SameSameIndustry/STM32_UDP2CAN_controller/CAN_PROTOCOL_TTL-SERVO.md

# CAN 通信プロトコル仕様書

実装: [`Core/Inc/can_protocol.h`](Core/Inc/can_protocol.h) / [`Core/Src/can_protocol.c`](Core/Src/can_protocol.c)

## バス設定

| 項目 | 値 |
|---|----|
| ボーレート | 1 Mbps（クラシック CAN） |
| ID 形式 | 標準 11bit |
| ノード ID | `0x21`（`can_protocol.h` の `CAN_NODE_ID` で変更可能） |
| 通信方向 | 受信専用（この基板からは送信しない） |

## フレームフォーマット

`Data[0]` がコマンドバイト、`Data[1..]` がペイロード（リトルエンディアン）。

| コマンド | `Data[0]` | DLC | ペイロード |
|---|:---:|:---:|---|
| RESET | `0x00` | 1 | なし |
| SET_TARGET | `0x01` | 3 | `Data[1:2]` = **int16 LE（符号付き）**、絶対原点（180°固定、生カウント2048）からのオフセット（カウント単位、`角度[°] = カウント値 × 360 / 4096`、範囲 ±180°＝±2048） |

原点は180°（生カウント2048）に固定されており、原点自体を動かすコマンドはない。STS3215サーボの`Present_Position`/`Goal_Position`は0〜4095（0〜360°）レンジ。

## 挙動

| 送信データ | 挙動 |
|---|---|
| `ID=0x21 Data=00` | サーボの現在位置を読み取り、それを新しい目標値としてそのまま指令する（その場で停止） |
| `ID=0x21 Data=01 00 00`（オフセット0） | 目標角度を原点そのもの＝180°に更新 |
| `ID=0x21 Data=01 00 04`（オフセット +1024 = +90°） | 目標角度を180°+90°=270°（生カウント3072）に更新 |
| `ID=0x21 Data=01 00 FC`（オフセット -1024 = -90°） | 目標角度を180°-90°=90°（生カウント1024）に更新 |

目標値（180°±オフセット）は0〜4095にクランプされる（`wave_motor`用プロトコルと異なり、範囲外はラップせず両端で頭打ちになる）。

`CAN_NODE_ID` 以外宛のフレームとリモートフレームは無視される。

## LEDインジケータ（PA8、WS2812B互換 ×6、デイジーチェーン）

受信したコマンドに応じて、6灯すべてを同じ色に切り替える（[`Core/Src/ws2812.c`](STM_TTLSERVO/Core/Src/ws2812.c) 実装）。

| コマンド | LED色 |
|---|---|
| RESET | 白 |
| SET_TARGET | 青 |
