SameSameIndustry/STM32_UDP2CAN_controller/CAN_PROTOCOL_wave_motor.md

# CAN 通信プロトコル仕様書

実装: [`Core/Inc/can_protocol.h`](Core/Inc/can_protocol.h) / [`Core/Src/can_protocol.c`](Core/Src/can_protocol.c)

## バス設定

| 項目 | 値 |
|---|----|
| ボーレート | 1 Mbps（クラシック CAN） |
| ID 形式 | 標準 11bit |
| ノード ID | `0x11`（`can_protocol.h` の `CAN_NODE_ID` で変更可能） |
| 通信方向 | 受信専用（この基板からは送信しない） |

## フレームフォーマット

`Data[0]` がコマンドバイト、`Data[1..]` がペイロード（リトルエンディアン）。

| コマンド | `Data[0]` | DLC | ペイロード |
|---|:---:|:---:|---|
| RESET | `0x00` | 1 | なし |
| SET_TARGET | `0x01` | 3 | `Data[1:2]` = **int16 LE（符号付き）**、絶対原点（AS5600 生カウント 2048 = 180°固定）からのオフセット（カウント単位、`角度[°] = カウント値 × 360 / 4096`、±180° ≒ ±2048） |

原点は AS5600 の絶対値 180°（生カウント 2048）に固定されており、`SET_ORIGIN` のような動的な原点変更コマンドは無い。

## 挙動

| 送信データ | 挙動 |
|---|---|
| `ID=0x11 Data=00` | 現在位置を新しい目標値にする → 現在の速度からなめらかに減速してその場に停止する |
| `ID=0x11 Data=01 00 00`（オフセット 0） | 目標角度を絶対原点そのもの＝180°に更新 |
| `ID=0x11 Data=01 00 04`（オフセット +1024 = +90°） | 目標角度を 180°+90° = 270°（AS5600 生カウント 3072）に更新 |
| `ID=0x11 Data=01 00 FC`（オフセット -1024 = -90°） | 目標角度を 180°-90° = 90°（AS5600 生カウント 1024）に更新 |

範囲外の値（例: ±180° を超えるオフセット）を送っても拒否はされず、円周上をラップして解釈される。`CAN_NODE_ID` 以外宛のフレームとリモートフレームは無視される。
