SameSameIndustry/STM32_UDP2CAN_controller/UDP_w5500/jlcpcb/production_files/BOM-UDP_w5500.csv

Comment | Designator | Footprint | LCSC | Quantity
0R/1206 | R22 | R_1206_3216Metric | C22356801 | 1
100nF | C14,C2,C22,C26,C27,C30,C31,C32,C33,C5,C8 | C_0603_1608Metric_Pad1.08x0.95mm_HandSolder | C14663 | 11
10K | R23,R25 | R_0603_1608Metric_Pad0.98x0.95mm_HandSolder | C25804 | 2
10R | R21 | R_0603_1608Metric_Pad0.98x0.95mm_HandSolder | C22859 | 1
10nF | C15,C18,C29 | C_0603_1608Metric_Pad1.08x0.95mm_HandSolder | C57112 | 3
10uF | C13,C6 | C_0603_1608Metric_Pad1.08x0.95mm_HandSolder | C19702 | 2
12.4K | R19 | R_0603_1608Metric_Pad0.98x0.95mm_HandSolder | C22865 | 1
120R | R7,R8 | R_0603_1608Metric_Pad0.98x0.95mm_HandSolder | C22787 | 2
16Hz | Y2 | Crystal_SMD_3225-4Pin_3.2x2.5mm | C13738 | 1
18pF | C10,C9 | C_0603_1608Metric_Pad1.08x0.95mm_HandSolder | C1647 | 2
1uF | C25 | C_0603_1608Metric_Pad1.08x0.95mm_HandSolder | C15849 | 1
1uF/35V | C7 | C_0603_1608Metric_Pad1.08x0.95mm_HandSolder | C15849 | 1
2.2K | R27,R28 | R_0603_1608Metric_Pad0.98x0.95mm_HandSolder | C4190 | 2
22nF | C19 | C_0603_1608Metric_Pad1.08x0.95mm_HandSolder | C21122 | 1
22uF | C12,C16 | C_0603_1608Metric_Pad1.08x0.95mm_HandSolder | C59461 | 2
25MHz | Y1 | Crystal_SMD_3225-4Pin_3.2x2.5mm | C9006 | 1
3.3R | R10,R11,R12,R9 | R_0603_1608Metric_Pad0.98x0.95mm_HandSolder | C22979 | 4
330R | R13,R14 | R_0603_1608Metric_Pad0.98x0.95mm_HandSolder | C23138 | 2
4.7K | R2,R3,R5 | R_0603_1608Metric_Pad0.98x0.95mm_HandSolder | C23162 | 3
4.7uF | C17,C28 | C_0603_1608Metric_Pad1.08x0.95mm_HandSolder | C19666 | 2
470 | R17,R24 | R_0603_1608Metric_Pad0.98x0.95mm_HandSolder | C23179 | 2
470R | R26 | R_0603_1608Metric_Pad0.98x0.95mm_HandSolder | C23179 | 1
49.9R | R15,R16,R18,R20 | R_0603_1608Metric_Pad0.98x0.95mm_HandSolder | C23185 | 4
6.8nF | C20,C21 | C_0603_1608Metric_Pad1.08x0.95mm_HandSolder | C1631 | 2
6.8pF | C23,C24 | C_0603_1608Metric_Pad1.08x0.95mm_HandSolder | C1679 | 2
74AHCT1G125 | U7 | SOT-23-5_HandSoldering | C20617900 | 1
AMS1117-3.3 | U4 | SOT-223-3_TabPin2 | C6186 | 1
AR02016 | SW1,SW2 | SW-SMD_L3.9-W3.0-P4.45 | C720477 | 2
Blue | D2,D3 | LED_0603_1608Metric_Pad1.05x0.95mm_HandSolder | C7012319 | 2
CYA1040-68UH | L2 | IND-SMD_L11.6-W10.1 | C6364682 | 1
LCMGG160808T121RG | L1 | L_0603_1608Metric | C14709 | 1
MCP2562-E-SN | U5 | SOIC-8_3.9x4.9mm_P1.27mm | C53609 | 1
S4B-PH-SM4 | J10,J11,J12,J9 | JST_PH_S4B-PH-SM4-TB_1x04-1MP_P2.00mm_Horizontal | C265102 | 4
SS34 | D1 | D_SMA | C8678 | 1
STM32G431CBTx | U6 | LQFP-48_7x7mm_P0.5mm | C529355 | 1
W5500 | U3 | LQFP-48_7x7mm_P0.5mm | C32843 | 1
XL1509-5.0 | U1 | SOIC-8_3.9x4.9mm_P1.27mm | C2902368 | 1
XT30-2+2 | J3 | CONN-TH_4P-XT30PW-M |  | 1
XT60 | J1 | AMASS_XT60IPW-M_1x03_P7.20mm_Horizontal |  | 1
470uF/35V | C4 | CP_Radial_D10.0mm_P5.00mm |  | 1
XT60 | J2 | AMASS_XT60PW-F_1x02_P7.20mm_Horizontal |  | 1
XT30-2+2 | J4 | CONN-TH_4P-XT30PW-M |  | 1
XT30-2+2 | J5 | CONN-TH_4P-XT30PW-M |  | 1
~ | J7 | RJ45-TH_HR911105A |  | 1
XT30-2+2 | J6 | CONN-TH_4P-XT30PW-M |  | 1
WS2812B | D4 | LED_WS2812B_PLCC4_5.0x5.0mm_P3.2mm |  | 1
GND | TP2 | TestPoint_Pad_D3.0mm |  | 1
2.54-5 | J8 | PinHeader_1x05_P2.54mm_Vertical |  | 1
5V | TP1 | TestPoint_Pad_D3.0mm |  | 1
WS2812B | D5 | LED_WS2812B_PLCC4_5.0x5.0mm_P3.2mm |  | 1
220uF/35V | C11 | CP_Radial_D8.0mm_P3.50mm |  | 1
WS2812B | D8 | LED_WS2812B_PLCC4_5.0x5.0mm_P3.2mm |  | 1
WS2812B | D11 | LED_WS2812B_PLCC4_5.0x5.0mm_P3.2mm |  | 1
WS2812B | D6 | LED_WS2812B_PLCC4_5.0x5.0mm_P3.2mm |  | 1
WS2812B | D9 | LED_WS2812B_PLCC4_5.0x5.0mm_P3.2mm |  | 1
WS2812B | D10 | LED_WS2812B_PLCC4_5.0x5.0mm_P3.2mm |  | 1
WS2812B | D7 | LED_WS2812B_PLCC4_5.0x5.0mm_P3.2mm |  | 1
