SameSameIndustry/STM32_UDP2CAN_controller/UDP_w5500/3D/3D/UDP_w5500.step

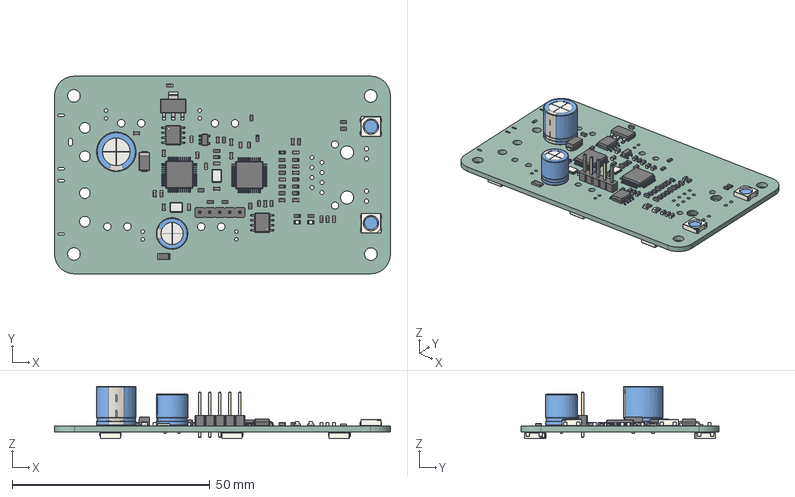
[picture p1: CAD file, 2026-08-07]
UDP_w5500/3D/3D/UDP_w5500.step
85.0 x 50.0 x 13.3 mm
C_0603_1608Metric x 29
R_0603_1608Metric x 24
CP_Radial_D10.0mm_P5.00mm
Crystal_SMD_3225-4Pin_3.2x2.5mm x 2
LED_0603_1608Metric x 2
L_0603_1608Metric
SOT-223
SOIC-8_3.9x4.9mm_P1.27mm x 2
LED_WS2812B_PLCC4_5.0x5.0mm_P3.2mm x 8
SOT-23-5
LQFP-48_7x7mm_P0.5mm x 2
PinHeader_1x05_P2.54mm_Vertical
CP_Radial_D8.0mm_P3.50mm
R_1206_3216Metric
D_SMA
UDP_w5500_PCB
