SameSameIndustry/STM32_UDP2CAN_controller/UDP_w5500/3D/3D_base_transperanet.stl

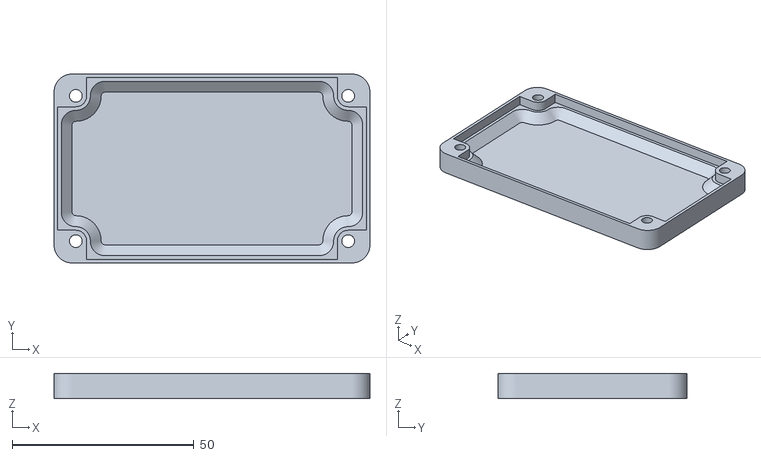
[picture p2: CAD file, 2026-10-04]
UDP_w5500/3D/3D_base_transperanet.stl
87.0 x 52.0 x 7.00
