SameSameIndustry/STM32_UDP2CAN_controller/UDP_w5500/3D/3D_base.stl

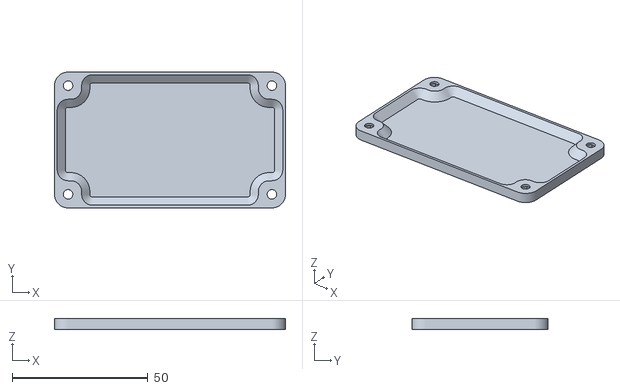
[picture p4: CAD file, 2026-08-07]
UDP_w5500/3D/3D_base.stl
85.0 x 50.0 x 4.00
