SameSameIndustry/STM32_UDP2CAN_controller/(list of files, cad)

Other CAD files:
UDP_w5500/3D/3D/UDP_w5500/UDP_w5500/CP_Radial_D10.0mm_P5.00mm.ipt
UDP_w5500/3D/3D/UDP_w5500/UDP_w5500/CP_Radial_D8.0mm_P3.50mm.ipt
UDP_w5500/3D/3D/UDP_w5500/UDP_w5500/C_0603_1608Metric.ipt
UDP_w5500/3D/3D/UDP_w5500/UDP_w5500/Crystal_SMD_3225-4Pin_3.2x2.5mm.ipt
UDP_w5500/3D/3D/UDP_w5500/UDP_w5500/D_SMA.ipt
UDP_w5500/3D/3D/UDP_w5500/UDP_w5500/LED_0603_1608Metric.ipt
UDP_w5500/3D/3D/UDP_w5500/UDP_w5500/LED_WS2812B_PLCC4_5.0x5.0mm_P3.2mm.ipt
UDP_w5500/3D/3D/UDP_w5500/UDP_w5500/LQFP-48_7x7mm_P0.5mm.ipt
UDP_w5500/3D/3D/UDP_w5500/UDP_w5500/L_0603_1608Metric.ipt
UDP_w5500/3D/3D/UDP_w5500/UDP_w5500/PinHeader_1x05_P2.54mm_Vertical.ipt
UDP_w5500/3D/3D/UDP_w5500/UDP_w5500/R_0603_1608Metric.ipt
UDP_w5500/3D/3D/UDP_w5500/UDP_w5500/R_1206_3216Metric.ipt
UDP_w5500/3D/3D/UDP_w5500/UDP_w5500/SOIC-8_3.9x4.9mm_P1.27mm.ipt
UDP_w5500/3D/3D/UDP_w5500/UDP_w5500/SOT-223.ipt
UDP_w5500/3D/3D/UDP_w5500/UDP_w5500/SOT-23-5.ipt
UDP_w5500/3D/3D/UDP_w5500/UDP_w5500/UDP_w5500.iam
UDP_w5500/3D/3D/UDP_w5500/UDP_w5500/UDP_w5500_PCB.ipt
UDP_w5500/3D/3D_base.ipt
UDP_w5500/3D/3D_base_transperanet.ipt
UDP_w5500/3D/3D_clear.ipt
UDP_w5500/3D/OldVersions/3D_base.0003.ipt
UDP_w5500/3D/OldVersions/3D_base_transperanet.0004.ipt
UDP_w5500/3D/OldVersions/3D_clear.0003.ipt
UDP_w5500/3D/UDP_w5500.step
UDP_w5500/3D/UDP_w5500/UDP_w5500/CP_Radial_D10.0mm_P5.00mm.ipt
UDP_w5500/3D/UDP_w5500/UDP_w5500/CP_Radial_D8.0mm_P3.50mm.ipt
UDP_w5500/3D/UDP_w5500/UDP_w5500/C_0603_1608Metric.ipt
UDP_w5500/3D/UDP_w5500/UDP_w5500/Crystal_SMD_3225-4Pin_3.2x2.5mm.ipt
UDP_w5500/3D/UDP_w5500/UDP_w5500/D_SMA.ipt
UDP_w5500/3D/UDP_w5500/UDP_w5500/LED_0603_1608Metric.ipt
UDP_w5500/3D/UDP_w5500/UDP_w5500/LED_WS2812B_PLCC4_5.0x5.0mm_P3.2mm.ipt
UDP_w5500/3D/UDP_w5500/UDP_w5500/LQFP-48_7x7mm_P0.5mm.ipt
UDP_w5500/3D/UDP_w5500/UDP_w5500/L_0603_1608Metric.ipt
UDP_w5500/3D/UDP_w5500/UDP_w5500/PinHeader_1x05_P2.54mm_Vertical.ipt
UDP_w5500/3D/UDP_w5500/UDP_w5500/R_0603_1608Metric.ipt
UDP_w5500/3D/UDP_w5500/UDP_w5500/R_1206_3216Metric.ipt
UDP_w5500/3D/UDP_w5500/UDP_w5500/SOIC-8_3.9x4.9mm_P1.27mm.ipt
UDP_w5500/3D/UDP_w5500/UDP_w5500/SOT-223.ipt
UDP_w5500/3D/UDP_w5500/UDP_w5500/SOT-23-5.ipt
UDP_w5500/3D/UDP_w5500/UDP_w5500/UDP_w5500.iam
UDP_w5500/3D/UDP_w5500/UDP_w5500/UDP_w5500_PCB.ipt
