SameSameIndustry/STM32_UDP2CAN_controller/UDP_w5500/schematics_w5500.pdf

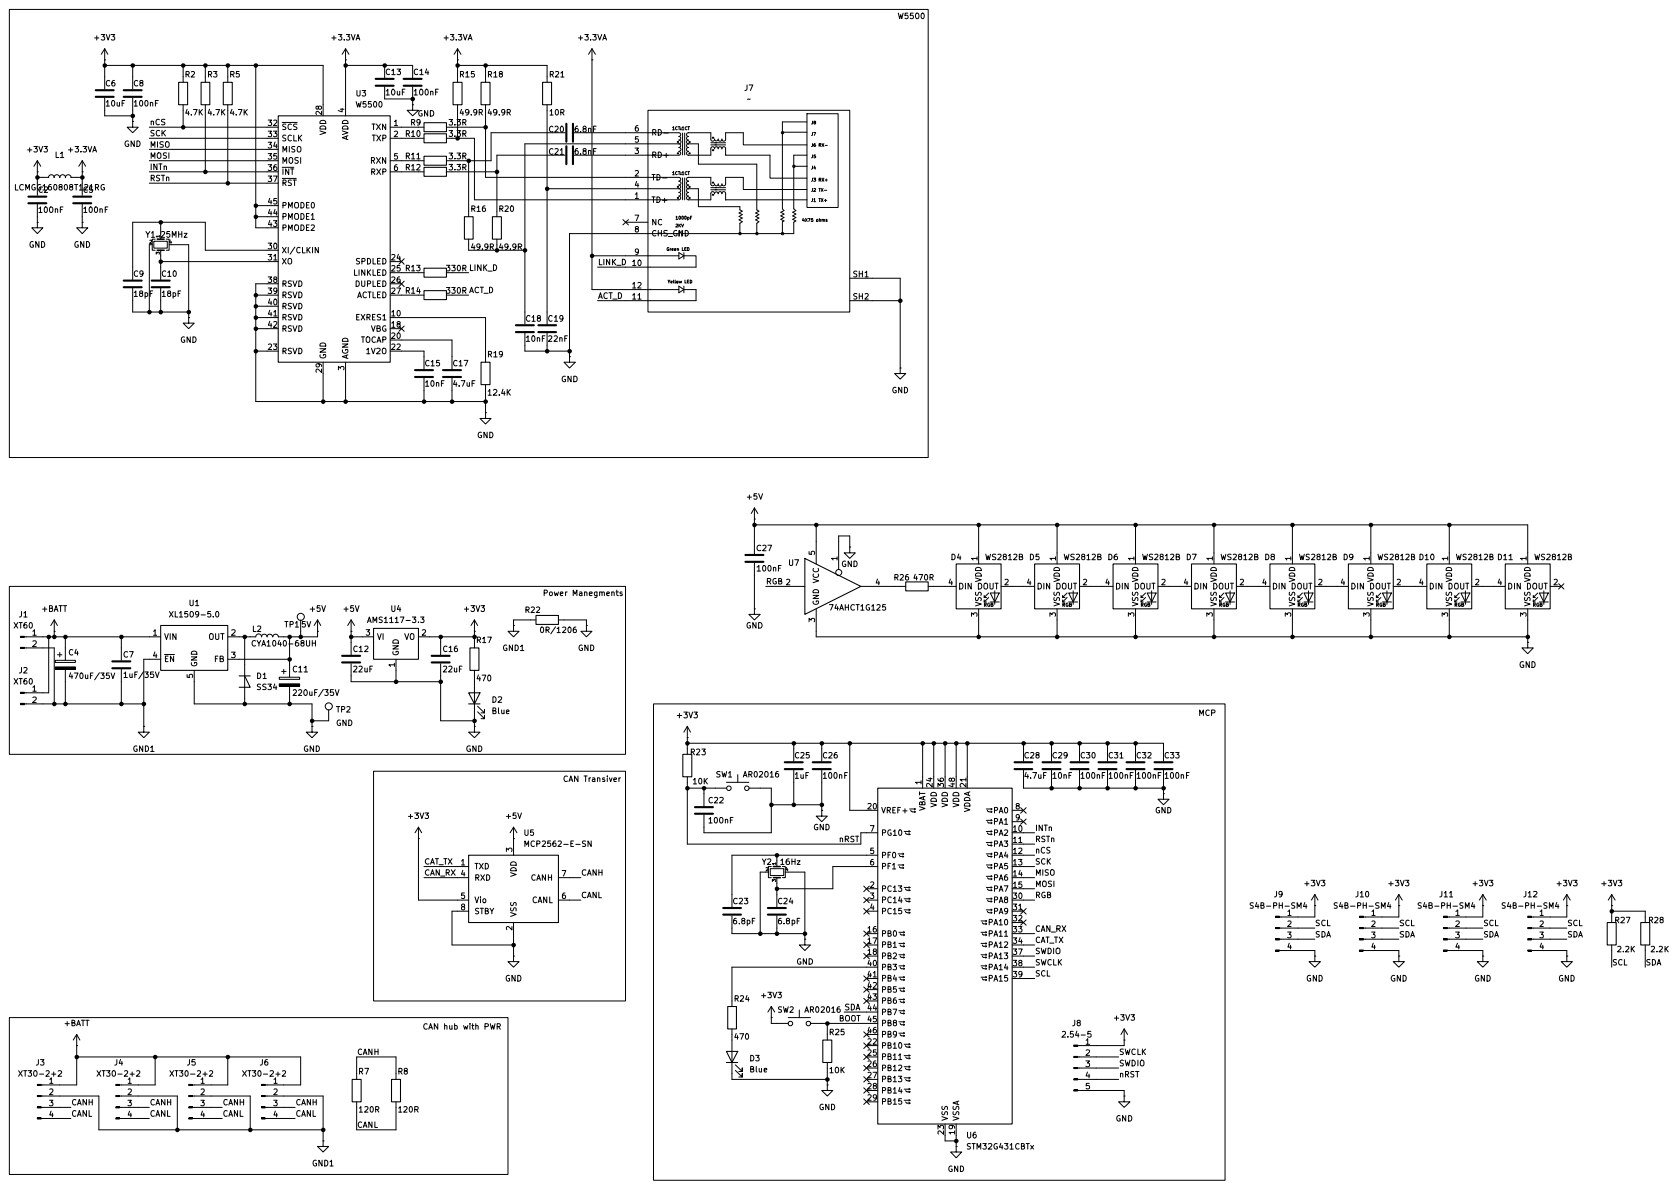
[picture p5: page 1]
