SameSameIndustry/STM32_UDP2CAN_controller/UDP_w5500/UDP_w5500.kicad_pcb

## KiCad design UDP_w5500/UDP_w5500.kicad_pcb (2026-08-07)

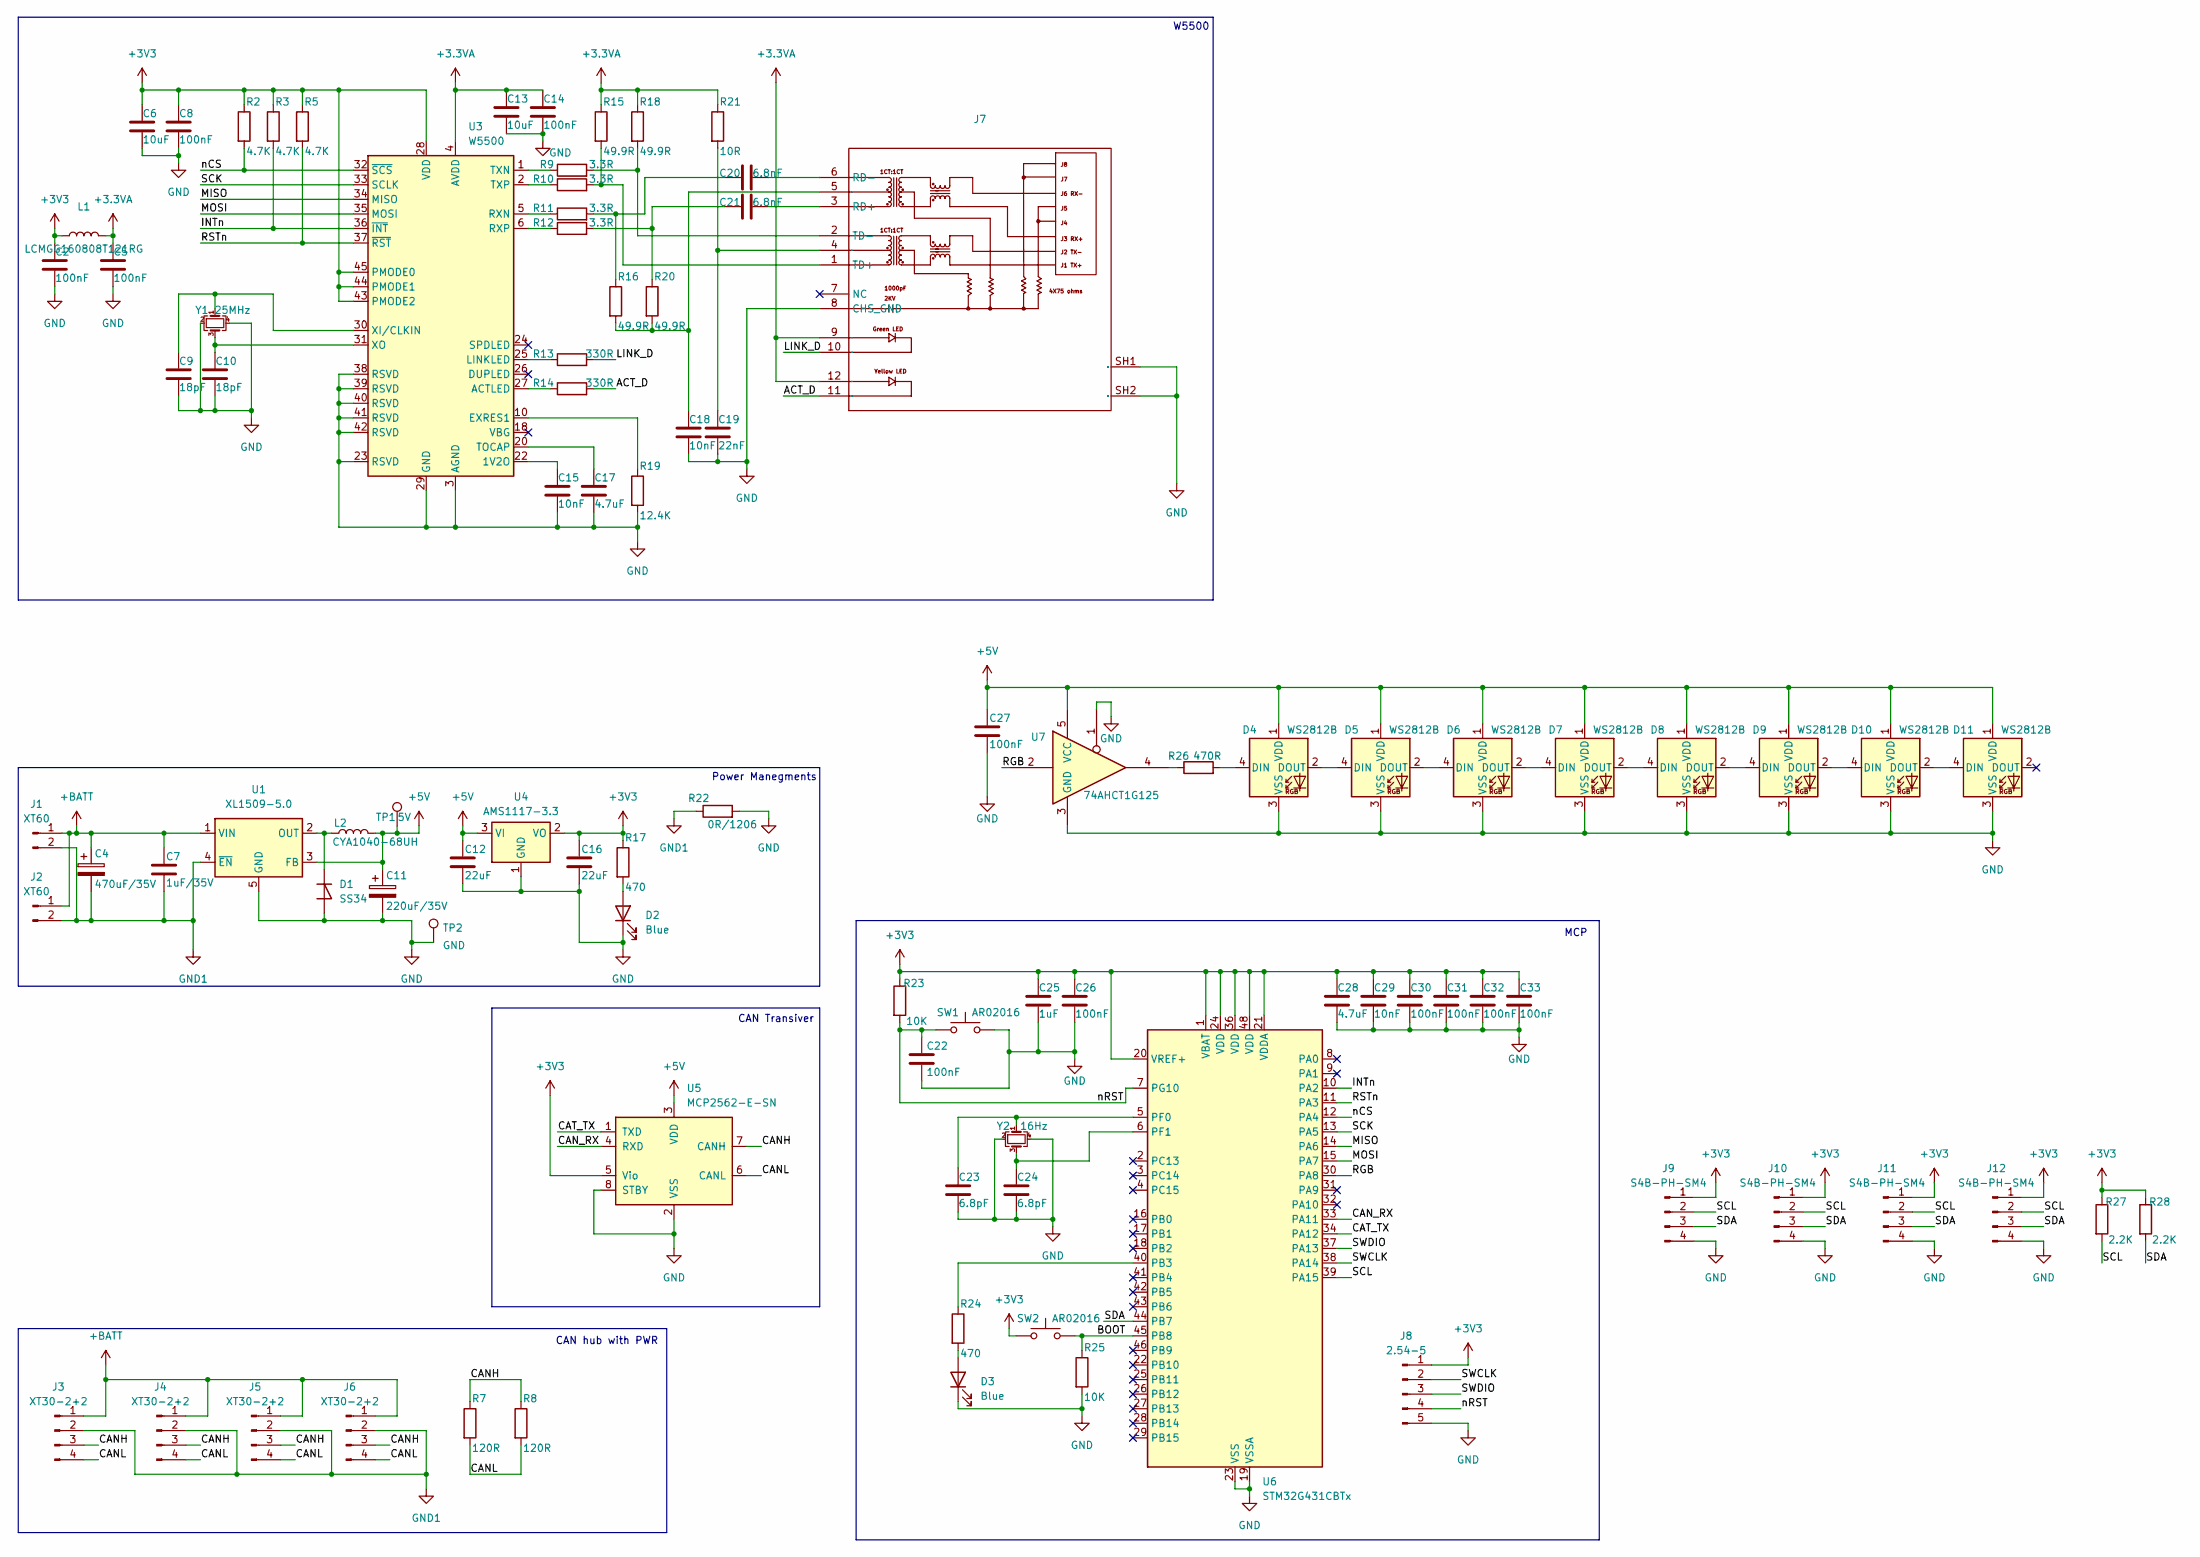
[picture p6: schematic UDP_w5500.kicad_sch]

Parts:
C2, C5, C8, C14, C22, C26, C27, C30, C31, C32, C33: 100nF; C_0603_1608Metric_Pad1.08x0.95mm_HandSolder; LCSC C14663
C4: 470uF/35V; CP_Radial_D10.0mm_P5.00mm
C6, C13: 10uF; C_0603_1608Metric_Pad1.08x0.95mm_HandSolder; LCSC C19702
C7: 1uF/35V; C_0603_1608Metric_Pad1.08x0.95mm_HandSolder; LCSC C15849
C9, C10: 18pF; C_0603_1608Metric_Pad1.08x0.95mm_HandSolder; LCSC C1647
C11: 220uF/35V; CP_Radial_D8.0mm_P3.50mm
C12, C16: 22uF; C_0603_1608Metric_Pad1.08x0.95mm_HandSolder; LCSC C59461
C15, C18, C29: 10nF; C_0603_1608Metric_Pad1.08x0.95mm_HandSolder; LCSC C57112
C17, C28: 4.7uF; C_0603_1608Metric_Pad1.08x0.95mm_HandSolder; LCSC C19666
C19: 22nF; C_0603_1608Metric_Pad1.08x0.95mm_HandSolder; LCSC C21122
C20, C21: 6.8nF; C_0603_1608Metric_Pad1.08x0.95mm_HandSolder; LCSC C1631
C23, C24: 6.8pF; C_0603_1608Metric_Pad1.08x0.95mm_HandSolder; LCSC C1679
C25: 1uF; C_0603_1608Metric_Pad1.08x0.95mm_HandSolder; LCSC C15849
D1: SS34; D_SMA; LCSC C8678
D2, D3: Blue; LED_0603_1608Metric_Pad1.05x0.95mm_HandSolder; LCSC C7012319
D4, D5, D6, D7, D8, D9, D10, D11: WS2812B; LED_WS2812B_PLCC4_5.0x5.0mm_P3.2mm
J1: XT60; AMASS_XT60IPW-M_1x03_P7.20mm_Horizontal
J2: XT60; AMASS_XT60PW-F_1x02_P7.20mm_Horizontal
J3, J4, J5, J6: XT30-2+2; CONN-TH_4P-XT30PW-M
J7: RJ45-TH_HR911105A; Manufacturer Part HR911105A; LCSC Part Name 弯插 带LED
J8: 2.54-5; PinHeader_1x05_P2.54mm_Vertical
J9, J10, J11, J12: S4B-PH-SM4; JST_PH_S4B-PH-SM4-TB_1x04-1MP_P2.00mm_Horizontal; LCSC C265102
L1: LCMGG160808T121RG; L_0603_1608Metric; LCSC C14709
L2: CYA1040-68UH; IND-SMD_L11.6-W10.1; LCSC C6364682
R2, R3, R5: 4.7K; R_0603_1608Metric_Pad0.98x0.95mm_HandSolder; LCSC C23162
R7, R8: 120R; R_0603_1608Metric_Pad0.98x0.95mm_HandSolder; LCSC C22787
R9, R10, R11, R12: 3.3R; R_0603_1608Metric_Pad0.98x0.95mm_HandSolder; LCSC C22979
R13, R14: 330R; R_0603_1608Metric_Pad0.98x0.95mm_HandSolder; LCSC C23138
R15, R16, R18, R20: 49.9R; R_0603_1608Metric_Pad0.98x0.95mm_HandSolder; LCSC C23185
R17, R24: 470; R_0603_1608Metric_Pad0.98x0.95mm_HandSolder; LCSC C23179
R19: 12.4K; R_0603_1608Metric_Pad0.98x0.95mm_HandSolder; LCSC C22865
R21: 10R; R_0603_1608Metric_Pad0.98x0.95mm_HandSolder; LCSC C22859
R22: 0R/1206; R_1206_3216Metric; LCSC C22356801
R23, R25: 10K; R_0603_1608Metric_Pad0.98x0.95mm_HandSolder; LCSC C25804
R26: 470R; R_0603_1608Metric_Pad0.98x0.95mm_HandSolder; LCSC C23179
R27, R28: 2.2K; R_0603_1608Metric_Pad0.98x0.95mm_HandSolder; LCSC C4190
SW1, SW2: AR02016; SW-SMD_L3.9-W3.0-P4.45; LCSC C720477
TP1: 5V; TestPoint_Pad_D3.0mm
TP2: GND; TestPoint_Pad_D3.0mm
U1: XL1509-5.0; SOIC-8_3.9x4.9mm_P1.27mm; LCSC C2902368
U3: W5500; LQFP-48_7x7mm_P0.5mm; LCSC C32843
U4: AMS1117-3.3; SOT-223-3_TabPin2; LCSC C6186
U5: MCP2562-E-SN; SOIC-8_3.9x4.9mm_P1.27mm; LCSC C53609
U6: STM32G431CBTx; LQFP-48_7x7mm_P0.5mm; LCSC C529355
U7: 74AHCT1G125; SOT-23-5_HandSoldering; LCSC C20617900
Y1: 25MHz; Crystal_SMD_3225-4Pin_3.2x2.5mm; LCSC C9006
Y2: 16Hz; Crystal_SMD_3225-4Pin_3.2x2.5mm; LCSC C13738

Connections:
+3.3VA: C5.1, C13.1, C14.1, J7.9, J7.12, L1.2, R15.1, R18.1, R21.1, U3.4 (AVDD), U3.8 (AVDD), U3.11 (AVDD), U3.15 (AVDD), U3.17 (AVDD), U3.21 (AVDD)
+3V3: C2.1, C6.1, C8.1, C16.1, C25.1, C26.1, C28.1, C29.1, C30.1, C31.1, C32.1, C33.1, J8.1, J9.1, J10.1, J11.1, J12.1, L1.1, R2.1, R3.1, R5.1, R17.1, R23.1, R27.1, R28.1, SW2.1, U3.28 (VDD), U3.43 (PMODE2), U3.44 (PMODE1), U3.45 (PMODE0), U4.2 (VO), U5.5 (Vio), U6.1 (VBAT), U6.20 (VREF+), U6.21 (VDDA), U6.24 (VDD), U6.36 (VDD), U6.48 (VDD)
+5V: C11.1, C12.1, C27.1, D4.1 (VDD), D5.1 (VDD), D6.1 (VDD), D7.1 (VDD), D8.1 (VDD), D9.1 (VDD), D10.1 (VDD), D11.1 (VDD), L2.2, TP1.1, U1.3 (FB), U4.3 (VI), U5.3 (VDD), U7.5 (VCC)
+BATT: C4.1, C7.1, J1.1, J2.1, J3.1, J4.1, J5.1, J6.1, U1.1 (VIN)
/ACT_D: J7.11, R14.2
/BOOT: R25.1, SW2.2, U6.45 (PB8)
/CANH: J3.3, J4.3, J5.3, J6.3, R7.1, R8.1, U5.7 (CANH)
/CANL: J3.4, J4.4, J5.4, J6.4, R7.2, R8.2, U5.6 (CANL)
/CAN_RX: U5.4 (RXD), U6.33 (PA11)
/CAT_TX: U5.1 (TXD), U6.34 (PA12)
/INTn: R3.2, U3.36 (~INT), U6.10 (PA2)
/LINK_D: J7.10, R13.2
/MISO: U3.34 (MISO), U6.14 (PA6)
/MOSI: U3.35 (MOSI), U6.15 (PA7)
/RGB: U6.30 (PA8), U7.2
/RSTn: R5.2, U3.37 (~RST), U6.11 (PA3)
/SCK: U3.33 (SCLK), U6.13 (PA5)
/SCL: J9.2, J10.2, J11.2, J12.2, R27.2, U6.39 (PA15)
/SDA: J9.3, J10.3, J11.3, J12.3, R28.2, U6.44 (PB7)
/SWCLK: J8.2, U6.38 (PA14)
/SWDIO: J8.3, U6.37 (PA13)
/nCS: R2.2, U3.32 (~SCS), U6.12 (PA4)
/nRST: C22.1, J8.4, R23.2, SW1.1, U6.7 (PG10)
GND: C2.2, C5.2, C6.2, C8.2, C9.2, C10.2, C11.2, C12.2, C13.2, C14.2, C15.2, C16.2, C17.2, C18.2, C19.2, C22.2, C23.2, C24.2, C25.2, C26.2, C27.2, C28.2, C29.2, C30.2, C31.2, C32.2, C33.2, D1.2 (A), D2.1 (K), D3.1 (K), D4.3 (VSS), D5.3 (VSS), D6.3 (VSS), D7.3 (VSS), D8.3 (VSS), D9.3 (VSS), D10.3 (VSS), D11.3 (VSS), J7.8 (CHS_GND), J7.SH1, J7.SH2, J8.5, J9.4, J10.4, J11.4, J12.4, R19.2, R22.2, R25.2, SW1.2, TP2.1, U1.5 (GND), U1.6 (GND), U1.7 (GND), U1.8 (GND), U3.3 (AGND), U3.9 (AGND), U3.14 (AGND), U3.16 (AGND), U3.19 (AGND), U3.23 (RSVD), U3.29 (GND), U3.38 (RSVD), U3.39 (RSVD), U3.40 (RSVD), U3.41 (RSVD), U3.42 (RSVD), U3.48 (AGND), U4.1 (GND), U5.2 (VSS), U5.8 (STBY), U6.19 (VSSA), U6.23 (VSS), U6.35 (VSS), U6.47 (VSS), U7.1, U7.3 (GND), Y1.2, Y1.4, Y2.2, Y2.4
GND1: C4.2, C7.2, J1.2, J2.2, J3.2, J4.2, J5.2, J6.2, R22.1, U1.4 (~EN)
unnamed: C18.1, J7.5, R16.2, R20.2
unnamed: C19.1, J7.4, R21.2
unnamed: C20.1, R11.2, R16.1
unnamed: C21.1, R12.2, R20.1
unnamed: D1.1 (K), L2.1, U1.2 (OUT)
unnamed: D2.2 (A), R17.2
unnamed: D3.2 (A), R24.2
unnamed: D4.4 (DIN), R26.2
unnamed: D4.2 (DOUT), D5.4 (DIN)
unnamed: D5.2 (DOUT), D6.4 (DIN)
unnamed: D6.2 (DOUT), D7.4 (DIN)
unnamed: D7.2 (DOUT), D8.4 (DIN)
unnamed: D8.2 (DOUT), D9.4 (DIN)
unnamed: D9.2 (DOUT), D10.4 (DIN)
unnamed: D10.2 (DOUT), D11.4 (DIN)
unnamed: C21.2, J7.3 (RD+)
unnamed: C20.2, J7.6 (RD-)
unnamed: J7.1 (TD+), R10.2, R15.2
unnamed: J7.2 (TD-), R9.2, R18.2
unnamed: R26.1, U7.4
unnamed: C15.1, U3.22 (1V2O)
unnamed: R14.1, U3.27 (ACTLED)
unnamed: R19.1, U3.10 (EXRES1)
unnamed: R13.1, U3.25 (LINKLED)
unnamed: R11.1, U3.5 (RXN)
unnamed: R12.1, U3.6 (RXP)
unnamed: C17.1, U3.20 (TOCAP)
unnamed: R9.1, U3.1 (TXN)
unnamed: R10.1, U3.2 (TXP)
unnamed: C9.1, U3.30 (XI/CLKIN), Y1.1
unnamed: C10.1, U3.31 (XO), Y1.3
unnamed: R24.1, U6.40 (PB3)
unnamed: C23.1, U6.5 (PF0), Y2.1
unnamed: C24.1, U6.6 (PF1), Y2.3

Notes on the sheet:
CAN hub with PWR
MCP
W5500
Power Manegments
CAN Transiver

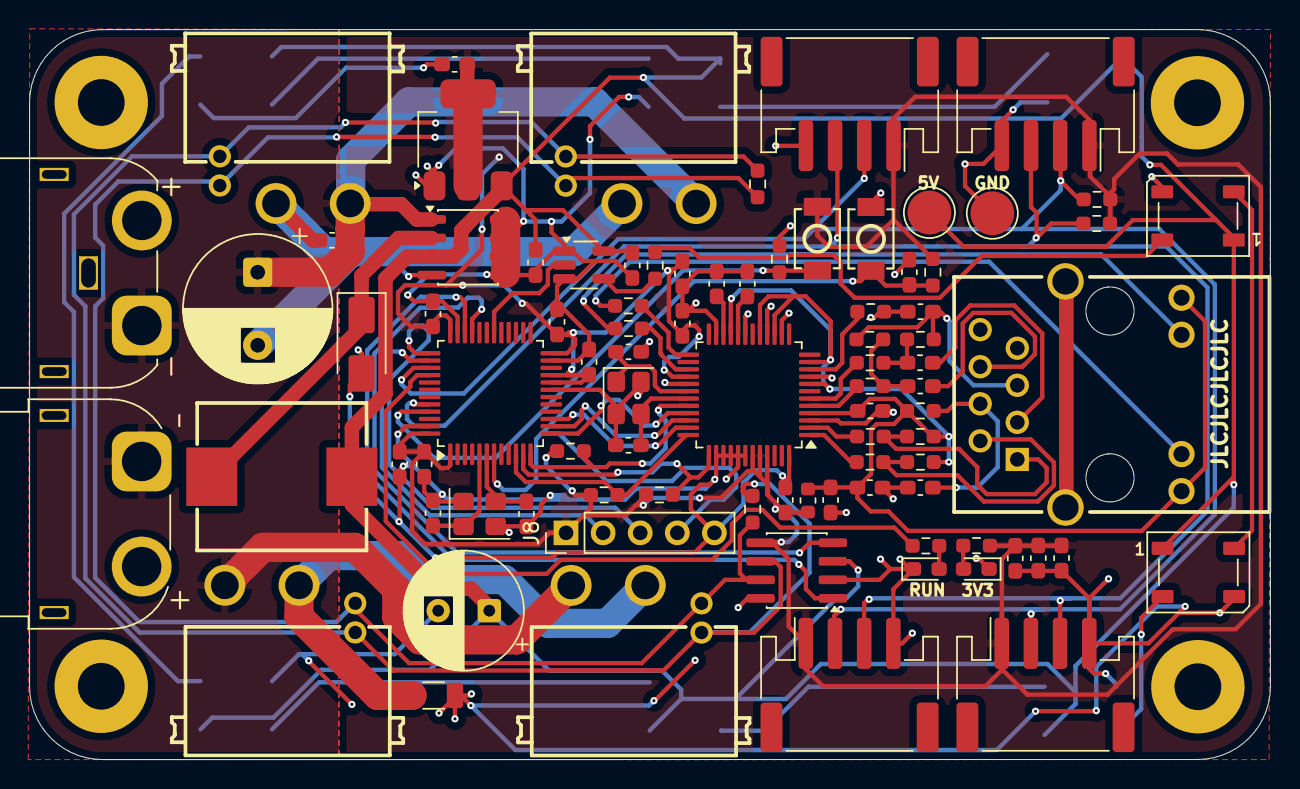
[picture p7: board UDP_w5500.kicad_pcb from above]

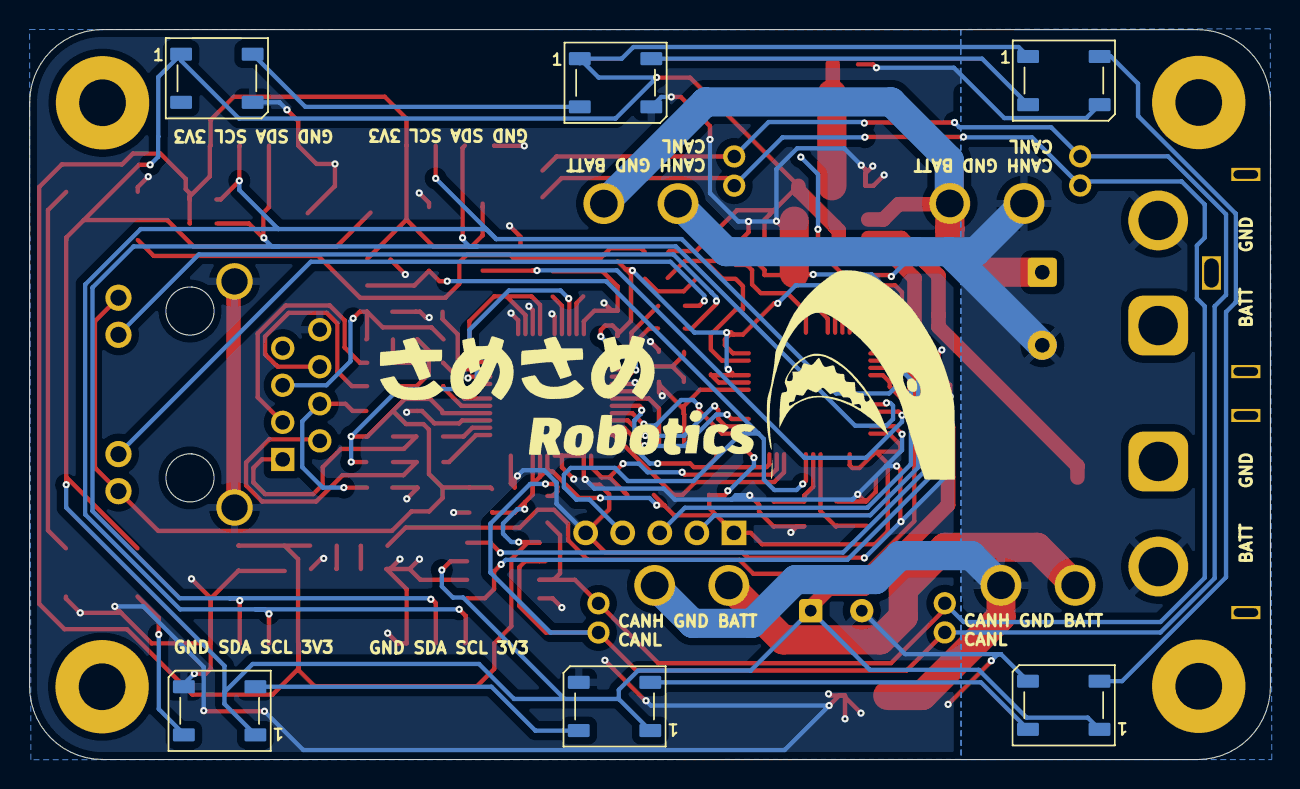
[picture p8: board UDP_w5500.kicad_pcb from below]

Board: 2 copper layers, 85.0 x 50.0 mm, 93 parts (6 on the bottom side), 59 nets.
