SameSameIndustry/STM32_UDP2CAN_controller/G431_w5500/Core/Src/main.c

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
/* Includes ------------------------------------------------------------------*/
#include "main.h"

/* USER CODE BEGIN Includes */
#include <stdio.h>
#include <string.h>
#include "wizchip_conf.h"
#include "socket.h"
#include "can_bus.h"
#include "can_udp_bridge.h"
#include "dji_c610.h"
#include "odrive_can.h"
#include "vesc_can.h"
#include "ttl_servo_can.h"
#include "wave_motor_can.h"
#include "gim6010.h"
#include "gim8018.h"
#include "hl_control_udp.h"
/* USER CODE END Includes */

/* USER CODE BEGIN PD */
// GIM8018-8はODrive互換と認識されているとのことなので、まずODrive CAN Simple
// プロトコルのnode_idとして扱う (ODrive公式デフォルトは0)。
// tools/can_id_scanner/can_id_scanner.py の「ODrive heartbeat」欄に出てくる
// node IDを見て、実機に合わせて確認・変更すること。
#define GIM_NODE_ID 0U

// GIM8018-8は減速比1/8 (モータ8回転 = 出力1回転)。
// SteadyWin公式のGIM6010-8マニュアル(同じ駆動基板ファミリー、tools/odrive_setup/
// odrive_configure.py 冒頭のコメント参照)によれば、このファームウェアには
// ODrive Pro(v0.6系)にあるload_encoder/commutation_encoderのような「出力軸専用
// エンコーダ」概念は存在せず、pos_estimate/Input_Posは常にモーター軸(エンコーダ)
// 基準のturnsである。よってGIM_GEAR_RATIO=8.0fが妥当なはずだが、GIM8018-8固有の
// マニュアルそのものは未確認なので、念のため出力軸を手でちょうど1回転させ
// can_id_scannerのPos[turn]の変化量が8.0になることを確認してから運用すること。
#define GIM_GEAR_RATIO 8.0f

// 比較用: 2025年のM5_Lower-Controller(lib/VescCAN)ではController ID 10, 20が
// 使われていた形跡があるが、GIM8018-8がこちらの可能性も完全には排除できないため
// 受信のみ監視する(実際のコマンド送信はしない)。tools/can_id_scanner の
// 「VESC status」欄に何か出てくるようなら、実はこちらが正解ということになる。
#define VESC_TEST_ID 10U

#define C610_ESC_ID  1U   // C610本体のダイヤル/DIPスイッチで設定したID (1-8)

// TTLサーボ基板 (プロジェクトルートの CAN_PROTOCOL_TTL-SERVO.md 参照、受信専用)。
// この基板の node_id (仕様書の既定値は0x21)。
#define TTL_SERVO_NODE_ID 0x21U

// wave motor基板 (プロジェクトルートの CAN_PROTOCOL_wave_motor.md 参照、受信専用)。
// 同じ機種がnode_id 0x11と0x12の2台接続されている。0x11と0x12は常に逆方向に
// 同じ角度だけ回転させる運用 (HLControlUDP_Poll()参照)。
#define WAVE_MOTOR_1_NODE_ID 0x11U
#define WAVE_MOTOR_2_NODE_ID 0x12U

// GIM6010-8 2台 (node_id 0x06, 0x07)。初期位置(ネイティブturns)からの出力角の偏差を
// 目標値として送る。目標値は0x06・0x07とも全く同じ値 (HLControlUDP_Poll()参照)。
#define GIM6010_A_NODE_ID 0x06U
#define GIM6010_B_NODE_ID 0x07U

// 0x06/0x07の「初期位置」(ネイティブ=モーター軸turns基準)。GUIからは設定できず、
// ここを編集して書き込むことで変更する。実機の電源投入時の実位置とは無関係
// (単なる目標値計算の基準点オフセット)。
#define GIM6010_A_INITIAL_NATIVE_TURNS -0.44f
#define GIM6010_B_INITIAL_NATIVE_TURNS -0.22f

// GIM8018-8 2台 (node_id 0x04, 0x05)。GIM6010(0x06/0x07)と同じ考え方だが、
// こちらは目標値が互い違い(符号反転・同じ大きさ)になる (HLControlUDP_Poll()参照)。
#define GIM8018_C_NODE_ID 0x04U
#define GIM8018_D_NODE_ID 0x05U

// 0x04/0x05の「初期位置」(ネイティブturns基準)。GIM6010と同様GUIからは設定できず、
// ここを編集して書き込むことで変更する。
#define GIM8018_C_INITIAL_NATIVE_TURNS 0.0f
#define GIM8018_D_INITIAL_NATIVE_TURNS 0.0f

#define HEARTBEAT_SN    2U     // ハートビート専用ソケット (0=Helloデモ, 1=CAN-UDPブリッジと被らないもの)
#define HEARTBEAT_PORT  5002U

// 高レベル制御UDP (tools/hl_control/PROTOCOL_HL_CONTROL_UDP.md 参照)。
// PythonのGUIからOPEN/CLOSEボタン・ピッチ角目標値を受け取り、TTLサーボ(0x21)/
// wave motor(0x11, 0x12)へのCAN送信に変換する。CAN-UDPブリッジ(ソケット1, ポート5001)
// やハートビート(ソケット2, ポート5002)とは別の専用ソケット・ポートを使う。
#define HLCONTROL_SN    3U
#define HLCONTROL_PORT  5003U
/* USER CODE END PD */

FDCAN_HandleTypeDef hfdcan1;

SPI_HandleTypeDef hspi1;

TIM_HandleTypeDef htim1;
DMA_HandleTypeDef hdma_tim1_ch1;

/* USER CODE BEGIN PV */
ODriveCAN_Axis_t gim_axis;         // GIM8018-8 (本命: ODrive CAN Simple)
VescCAN_Motor_t vesc_test_motor;   // 比較用 (受信のみ監視、VESCプロトコルだった場合の保険)
TTLServoCAN_t ttl_servo;           // TTLサーボ基板 (CAN_PROTOCOL_TTL-SERVO.md, node_id=0x21)
WaveMotorCAN_t wave_motor;         // wave motor基板 1台目 (CAN_PROTOCOL_wave_motor.md, node_id=0x11)
WaveMotorCAN_t wave_motor2;        // wave motor基板 2台目 (同一機種, node_id=0x12、逆向きにスイング)
GIM6010_t gim6010_a;               // GIM6010-8 1台目 (node_id=0x06)
GIM6010_t gim6010_b;               // GIM6010-8 2台目 (node_id=0x07、Aと全く同じ目標値)
GIM8018_t gim8018_c;               // GIM8018-8 1台目 (node_id=0x04)
GIM8018_t gim8018_d;               // GIM8018-8 2台目 (node_id=0x05、Cと符号反転の偏差)
/* USER CODE END PV */

void SystemClock_Config(void);
static void MX_GPIO_Init(void);
static void MX_DMA_Init(void);
static void MX_TIM1_Init(void);
static void MX_SPI1_Init(void);
static HAL_StatusTypeDef SPI1_Configure(void);
static void MX_FDCAN1_Init(void);
/* USER CODE BEGIN PFP */
void ws2812_show(void);
void ws2812_fill_buffer(void);
/* USER CODE END PFP */

/* USER CODE BEGIN 0 */
#define LED_NUM 8
#define WS2812_BITS (LED_NUM * 24)

uint16_t ws2812_buf[WS2812_BITS];
uint8_t led_data[LED_NUM][3];  // GRB

#define TIM_PERIOD 59   // 48MHz / 800kHz - 1

#define T0H 17          // 0 の High パルス
#define T1H 33          // 1 の High パルス

volatile uint8_t ws2812_busy = 0;

void W5500_Select(void) {
    HAL_GPIO_WritePin(GPIOA, GPIO_PIN_4, GPIO_PIN_RESET); // ピン番号はご自身の環境に合わせて
}

void W5500_Unselect(void) {
    HAL_GPIO_WritePin(GPIOA, GPIO_PIN_4, GPIO_PIN_SET);
}

// SPI転送のタイムアウト[ms]。以前はHAL_MAX_DELAY(無制限待ち)だったため、モーター
// 駆動時の電気的ノイズ等でSPI転送が完了しなくなると、この呼び出しから二度と
// 戻らずメインループ全体が完全にハングする不具合が実機で複数回再現した
// (ハートビート・CAN中継とも無応答になる)。有限のタイムアウトにすることで
// 必ず呼び出し元に制御を返すようにする。
#define W5500_SPI_TIMEOUT_MS 20U

// SPI転送がタイムアウトした後の復旧処理。CSを確実にHighへ戻し、SPIペリフェラルを
// 再初期化することで、次回以降の呼び出しがブロックされ続けないようにする。
// 今回失敗した1バイト分のデータは失われるが、wizchip側は上位のソケット層で
// 通信が続かなければ再送・タイムアウト処理される想定。
static void W5500_SPI_Recover(void)
{
    W5500_Unselect();
    HAL_SPI_DeInit(&hspi1);
    /* MX_SPI1_Init()は失敗するとError_Handler()(=while(1)の永久ハング)を呼ぶため
     * ここでは使わない。SPI1_Configure()を直接呼び、失敗しても戻り値を無視して
     * 呼び出し元へ制御を返す(次回のSPI呼び出しのタイムアウトで再度ここに来て
     * 再試行するだけにとどめる)。 */
    (void)SPI1_Configure();
}

uint8_t W5500_ReadByte(void) {
    uint8_t rb = 0xFFU;
    if (HAL_SPI_Receive(&hspi1, &rb, 1, W5500_SPI_TIMEOUT_MS) != HAL_OK) {
        W5500_SPI_Recover();
    }
    return rb;
}

void W5500_WriteByte(uint8_t wb) {
    if (HAL_SPI_Transmit(&hspi1, &wb, 1, W5500_SPI_TIMEOUT_MS) != HAL_OK) {
        W5500_SPI_Recover();
    }
}

// HAL_Delay()の代わりに使う。待っている間もCAN<->UDPブリッジのポーリングと
// CANBus_Poll()(Bus-Off検出・自動復帰)を挟むことで、PCからのCAN送信コマンドへの
// 応答性と、CAN通信が止まったままにならないことを確保する (数msの粒度)
static void Delay_WithCANPoll(uint32_t ms)
{
    uint32_t start = HAL_GetTick();
    while ((HAL_GetTick() - start) < ms) {
        CANUDPBridge_Poll();
        CANBus_Poll();
        HLControlUDP_Poll();
        HAL_Delay(5);
    }
}
/* USER CODE END 0 */

/**
  * @brief  The application entry point.
  * @retval int
  */
int main(void)
{

  /* MCU Configuration--------------------------------------------------------*/

  /* Reset of all peripherals, Initializes the Flash interface and the Systick. */
  HAL_Init();

  /* Configure the system clock */
  SystemClock_Config();

  /* Initialize all configured peripherals */
  MX_GPIO_Init();
  MX_DMA_Init();
  MX_TIM1_Init();
  MX_SPI1_Init();
  MX_FDCAN1_Init();
  /* USER CODE BEGIN 2 */
  HAL_GPIO_WritePin(GPIOB, GPIO_PIN_3, GPIO_PIN_RESET);

  // 修正2: W5500の電源投入/リセット解除タイミング競合対策。
  //   基板は バッテリ→XL1509(5V)→AMS1117(3.3V) で大容量コンデンサ(C4 470uF等)を
  //   充電するため、3.3Vレールの立ち上がりに数十msかかる。MCUはそれより速く起動
  //   するので、電源が規定電圧に達する前にRSTnを解除するとW5500内部PLL/PHYが
  //   ロックできず、以後SPIは一見応答するのに通信できない状態(電源再投入まで復帰
  //   しない)になる。まずレール安定を待ってからリセットし、解除後の待ちも延ばす。
  HAL_Delay(200);                                        // 3.3Vレール安定待ち

  HAL_GPIO_WritePin(GPIOA, GPIO_PIN_3, GPIO_PIN_RESET);
  HAL_Delay(10);                                         // RSTn Low (最低500us、余裕をみて10ms)
  HAL_GPIO_WritePin(GPIOA, GPIO_PIN_3, GPIO_PIN_SET);
  HAL_Delay(150);                                        // PLLロック+安定待ち (旧50ms→150ms)
  // 初期色: UDPのポートを開く(socket()を呼ぶ)前は赤。通信状態表示LEDの
  // 「未通信」状態としてここで先に点灯させておく(以後は while(1) ループ内で
  // CANUDPBridge_HasClient()/HLControlUDP_HasReceived()を見て赤/青を切り替える)。
  for (int i = 0; i < LED_NUM; i++) {
      led_data[i][0] = 0;    // G
      led_data[i][1] = 100;  // R
      led_data[i][2] = 0;    // B
  }
  ws2812_show();

  // 1. ネットワーク情報の定義
  wiz_NetInfo gWIZNETINFO = {
      .mac = {0x00, 0x08, 0xdc, 0x11, 0x22, 0x33}, // 適当な値でOK
      .ip  = {192, 168, 1, 100},                  // W5500のIP
      .sn  = {255, 255, 255, 0},                  // サブネットマスク
      .gw  = {192, 168, 1, 1},                    // ゲートウェイ
      .dns = {8, 8, 8, 8},
      .dhcp = NETINFO_STATIC
  };

  // 2. SPI関数とCS制御関数の登録 (前述の関数を実装済みと想定)
  reg_wizchip_cs_cbfunc(W5500_Select, W5500_Unselect);
  reg_wizchip_spi_cbfunc(W5500_ReadByte, W5500_WriteByte);

  // 3. W5500の初期化 (ソケットバッファサイズの設定: 各2KB)
  uint8_t memsize[2][8] = {{2,2,2,2,2,2,2,2},{2,2,2,2,2,2,2,2}};
  if(wizchip_init(memsize[0], memsize[1]) != 0) {
      // 初期化失敗時の処理
  }
  wizchip_setnetinfo(&gWIZNETINFO);

  // 送信先の情報
  uint8_t dest_ip[4] = {192, 168, 1, 2}; // ★あなたのPCのIPアドレス
  uint16_t dest_port = 5000;             // 送信先ポート番号
  uint8_t sn = 0;                        // 使用するソケット番号

  // ハートビート: W5500/Ethernetが単体で生きているかを確認するための定期ブロードキャスト。
  // 送信先を255.255.255.255(ブロードキャスト)にしているので、PC側のIP設定が
  // まだ合っていなくても同一セグメント上ならWiresharkに映る (udp.port==5002 でフィルタ)。
  uint8_t hb_broadcast_ip[4] = {255, 255, 255, 255};
  uint32_t hb_seq = 0;
  socket(HEARTBEAT_SN, Sn_MR_UDP, HEARTBEAT_PORT, 0);
  {
      // このあと呼ぶMX_FDCAN1_Init()がもし固まった場合、while(1)ループに一切
      // 到達できず定期ハートビートも送られなくなる。それでも「Ethernetの初期化
      // 自体は成功した」ことを確認できるよう、ここで最低1発だけ即時送信しておく。
      char hb_msg[48];
      int hb_len = snprintf(hb_msg, sizeof(hb_msg), "HB (boot) tick=%lu\r\n",
                             (unsigned long)HAL_GetTick());
      if (hb_len > 0) {
          sendto(HEARTBEAT_SN, (uint8_t*)hb_msg, (uint16_t)hb_len, hb_broadcast_ip, HEARTBEAT_PORT);
      }
  }

  // CAN<->UDPブリッジ (CAN ID調査用)。ソケット1、ポート5001を使う (上記の"Hello"デモとは別ソケット)。
  // PC側からこのポートに一度何か送れば、以後は受信した全CANフレームがそのPCへ生転送される。
  CANUDPBridge_Init(1, 5001);

  // CANバスの起動 (フィルタ設定 + HAL_FDCAN_Start + Rx割り込み有効化)
  CANBus_Init(&hfdcan1);

  // DJI C610 (M2006用ESC) の初期化。ESC側のIDは基板のダイヤルATC/DIPで1〜8に設定しておく
  DJIC610_Init();

  // GIM8018-8の初期化。本命としてODrive CAN Simpleプロトコルで扱う。
  ODriveCAN_Init(&gim_axis, GIM_NODE_ID, GIM_GEAR_RATIO);
  // Position Controlに入る (Set_Controller_Mode(POSITION, POS_FILTER) +
  // Set_Axis_Requested_State(CLOSED_LOOP_CONTROL))。
  // モーター/エンコーダのキャリブレーションが済んでいない個体だと失敗するが、その場合も
  // 送信自体は害がなく、失敗はheartbeatのaxis_error/axis_stateから分かる。
  ODriveCAN_EnablePositionControl(&gim_axis);

  // 比較用: VESCプロトコルだった場合に備え、受信のみ監視する(コマンドは送らない)
  VescCAN_Init(&vesc_test_motor, VESC_TEST_ID);

  // TTLサーボ基板 (受信専用) の初期化。実機へは何も送信しない。
  TTLServoCAN_Init(&ttl_servo, TTL_SERVO_NODE_ID);

  // wave motor基板 (受信専用) の初期化。実機へは何も送信しない。
  WaveMotorCAN_Init(&wave_motor, WAVE_MOTOR_1_NODE_ID);
  WaveMotorCAN_Init(&wave_motor2, WAVE_MOTOR_2_NODE_ID);

  // GIM6010-8 2台 (node_id 0x06, 0x07) / GIM8018-8 2台 (node_id 0x04, 0x05)。
  // ODrive CAN SimpleのPosition Control(POS_FILTER)へ入れる。
  // ⚠ 4軸分をノーウェイトで連続送信すると、STM32G4のTx FIFO(HW的に3要素しか
  //   ない、can_bus.cのコメント参照)が溢れ、後方の軸(0x07以降)ほど設定フレームが
  //   欠落しやすいため、各軸の間にHAL_Delay()を挟む(メインループ開始前で
  //   CANUDPBridge_Poll等はまだ呼べないため、CANBus_Poll付きのDelay_WithCANPoll()
  //   ではなく単純なHAL_Delay()を使う。FDCANの送信自体はソフトのポーリングと
  //   無関係にハードウェアが自動で行うので、ここで待つだけでFIFOは空く)。
  GIM6010_Init(&gim6010_a, GIM6010_A_NODE_ID);
  GIM6010_EnterPositionControl(&gim6010_a);
  HAL_Delay(10);

  GIM6010_Init(&gim6010_b, GIM6010_B_NODE_ID);
  GIM6010_EnterPositionControl(&gim6010_b);
  HAL_Delay(10);

  GIM8018_Init(&gim8018_c, GIM8018_C_NODE_ID);
  GIM8018_EnterPositionControl(&gim8018_c);
  HAL_Delay(10);

  GIM8018_Init(&gim8018_d, GIM8018_D_NODE_ID);
  GIM8018_EnterPositionControl(&gim8018_d);
  HAL_Delay(10);

  // 高レベル制御UDP (Python GUIのOPEN/CLOSEボタン・ピッチ角目標値・GIM6010/GIM8018
  // ピッチ角目標値を受け取る)。GIM6010/GIM8018の初期位置はGUIから設定するのでは
  // なく、ここでプログラム側の定数(GIM6010_*_INITIAL_NATIVE_TURNS /
  // GIM8018_*_INITIAL_NATIVE_TURNS)として渡す。
  HLControlUDP_Init(HLCONTROL_SN, HLCONTROL_PORT, &ttl_servo, &wave_motor, &wave_motor2,
                     &gim6010_a, &gim6010_b,
                     GIM6010_A_INITIAL_NATIVE_TURNS, GIM6010_B_INITIAL_NATIVE_TURNS,
                     &gim8018_c, &gim8018_d,
                     GIM8018_C_INITIAL_NATIVE_TURNS, GIM8018_D_INITIAL_NATIVE_TURNS);
  /* USER CODE END 2 */

  /* Infinite loop */
  /* USER CODE BEGIN WHILE */
  while (1)
  {
    /* USER CODE END WHILE */

    /* USER CODE BEGIN 3 */
	    HAL_GPIO_TogglePin(GPIOB, GPIO_PIN_3);

        // ハートビート送信 (ループ1周につき1回、約1.5秒間隔)。
        // canBusOff はCAN Bus-Offからの自動復帰回数(CANBus_Poll()参照)。0以外なら
        // どこかのCANノード宛の送信でACKが返らずBus-Offになったことがある = 配線/
        // 相手側の設定(ボーレート・node_id)を疑うべきサイン。
        // txQFail はTx FIFO満杯等でCAN送信キューへの投入自体に失敗した回数
        // (CANBus_GetTxQueueFailures()参照)。増え続けているなら、どこかのノード宛の
        // 送信が詰まって他ノードの送信も巻き添えで失敗している可能性が高い。
        {
            char hb_msg[80];
            int hb_len = snprintf(hb_msg, sizeof(hb_msg), "HB seq=%lu tick=%lu canBusOff=%lu txQFail=%lu\r\n",
                                   (unsigned long)hb_seq++, (unsigned long)HAL_GetTick(),
                                   (unsigned long)CANBus_GetBusOffRecoveries(),
                                   (unsigned long)CANBus_GetTxQueueFailures());
            if (hb_len > 0) {
                sendto(HEARTBEAT_SN, (uint8_t*)hb_msg, (uint16_t)hb_len, hb_broadcast_ip, HEARTBEAT_PORT);
            }
        }

        // 通信状態表示LED: 生CANブリッジ(can_udp_bridge.c)または高レベル制御UDP
        // (hl_control_udp.c)のどちらかでPCから1度でもUDPを受信していれば青、
        // まだ一度も受信していなければ赤 (どちらのgetterも一度1になったら以後
        // 0に戻らないラッチ式なので、通信が一瞬でも成立すればそれ以降ずっと青のまま)。
        {
            uint8_t udp_active = (uint8_t)(CANUDPBridge_HasClient() || HLControlUDP_HasReceived());
            for (int i = 0; i < LED_NUM; i++) {
                led_data[i][0] = 0;                       // G
                led_data[i][1] = udp_active ? 0U : 100U;   // R (未通信=赤)
                led_data[i][2] = udp_active ? 100U : 0U;   // B (通信あり=青)
            }
        }
        ws2812_show();
        Delay_WithCANPoll(1500);

        // ソケットが開いていなければ開く
		if (getSn_SR(sn) == SOCK_CLOSED) {
			socket(sn, Sn_MR_UDP, 5000, 0);
		}

		// データの送信
		char *msg = "Hello from STM32G431!\r\n";
		sendto(sn, (uint8_t*)msg, strlen(msg), dest_ip, dest_port);

		HAL_GPIO_TogglePin(GPIOA, GPIO_PIN_5); // 生存確認用LED (LD2)
//		HAL_Delay(1000); // 1秒おき

        // GIM8018-8 (ODrive CAN Simple) の位置制御テスト。
        // 出力軸換算で 0 turn ⇔ 0.25 turn (90°) を約6秒(ループ4周)ごとに往復する。
        // ⚠ GIM_NODE_IDが実機と合っているか、GIM_GEAR_RATIOが実機と合っているか
        //    (odrive_can.hのコメント参照。誤っていると指令値と実移動量が8倍ズレる)、
        //    tools/can_id_scanner の「ODrive heartbeat」欄(axis_state=8 =
        //    CLOSED_LOOP_CONTROLになっているか)で確認してから通電すること。
        //    負荷を外した状態・電流制限をかけた電源でまず試すこと。
        //    axis_errorが非0だったり反応がなければ、モーター/エンコーダのキャリブレーションが
        //    済んでいない可能性がある(ODrive/GIM設定ツール側での作業が必要)。
        {
            static uint8_t pos_toggle_count = 0U;
            static float pos_target_turns = 0.0f;

            pos_toggle_count++;
            if (pos_toggle_count >= 4U) {
                pos_toggle_count = 0U;
                pos_target_turns = (pos_target_turns == 0.0f) ? 0.25f : 0.0f;
            }
            ODriveCAN_SetOutputPos(&gim_axis, pos_target_turns, 0.0f, 0.0f);
        }

        // GIM6010-8 2台 (0x06, 0x07) / GIM8018-8 2台 (0x04, 0x05) を起動時から確実に
        // クローズドループ(位置制御)で回し続けるため、Set_Controller_Mode +
        // Set_Axis_Requested_State(CLOSED_LOOP) を定期的に再送する。起動時に1回だけ
        // 送る実装だと、AutoRetransmission=DISABLE + ACK無し等でその1フレームが
        // ロストした場合に永久にIDLEのままになってしまうため、GIM8018-8(gim_axis)の
        // 位置指令と同様に継続的に送り直して確実性を上げる。
        // ⚠ 4軸分を同じループ周回で一気に送ると、STM32G4のTx FIFOがHW的に3要素しか
        //   ないため(can_bus.cのコメント参照)、CPU側がノーウェイトで積もうとして
        //   溢れ、一部のフレームがHAL_FDCAN_AddMessageToTxFifoQ()の失敗で静かに
        //   消えることがある(実際に0x07だけクローズドループに入らない不具合として
        //   発現した)。1周回につき1軸だけラウンドロビンで送ることでburstサイズを
        //   抑える(各軸は約4周回=6秒に1回の再送になるが、通常運用では十分な頻度)。
        // 同じ番の軸に、HLControlUDP_ResendLastTarget()でSet_Input_Posも併せて
        // 再送する。GUIから新規コマンドが来ない間もgim_axis(node0)と同様に目標値を
        // 送り続けることで、GIM8108-8側の入力タイムアウト等により単発コマンドだけ
        // では目標を見失ってしまう(と疑われる)問題に対応する。
        {
            static uint8_t gim_reassert_idx = 0U;

            /* EnterPositionControl()は呼ぶたびに無条件で2フレーム
             * (Set_Controller_Mode + Set_Axis_Requested_State)を送るため、既に
             * CLOSED_LOOP_CONTROLに入っている軸に対しても毎回送ってしまうと、
             * gim_axisの1フレーム+ここの2フレーム+ResendLastTargetの1フレーム=
             * 4フレームが同一ループでFDCAN TxFIFO(3要素)を溢れさせる。まだ
             * CLOSED_LOOP_CONTROLでない軸だけ送るようにし、通常運用時は
             * ResendLastTargetの1フレームのみにする。 */
            switch (gim_reassert_idx) {
                case 0U:
                    if (gim6010_a.odrv.axis_state != ODRIVE_AXIS_STATE_CLOSED_LOOP_CONTROL) {
                        GIM6010_EnterPositionControl(&gim6010_a);
                    }
                    break;
                case 1U:
                    if (gim6010_b.odrv.axis_state != ODRIVE_AXIS_STATE_CLOSED_LOOP_CONTROL) {
                        GIM6010_EnterPositionControl(&gim6010_b);
                    }
                    break;
                case 2U:
                    if (gim8018_c.odrv.axis_state != ODRIVE_AXIS_STATE_CLOSED_LOOP_CONTROL) {
                        GIM8018_EnterPositionControl(&gim8018_c);
                    }
                    break;
                default:
                    if (gim8018_d.odrv.axis_state != ODRIVE_AXIS_STATE_CLOSED_LOOP_CONTROL) {
                        GIM8018_EnterPositionControl(&gim8018_d);
                    }
                    break;
            }
            HLControlUDP_ResendLastTarget(gim_reassert_idx);
            gim_reassert_idx = (uint8_t)((gim_reassert_idx + 1U) % 4U);
        }

        // GIM6010 A(0x06)/B(0x07)は常に同じ目標値を送っているが、実機で出力角に
        // 定常的なズレが残る場合があるため、実測角度差から低速に補正する
        // (GIM6010_A/B_INITIAL_NATIVE_TURNSのOFFSETは変更しない。詳細は
        // hl_control_udp.hのコメント参照)。メインループ1周(約1.5秒)に1回で十分。
        HLControlUDP_UpdateGim6010Sync();

        // 固定の振り付けシーケンス(Sequence_Update()/s_seq_steps[])は無効化し、
        // 代わりにPython GUIからの高レベル制御UDP(OPEN/CLOSEボタン・ピッチ角目標値)を
        // その場で処理する。HLControlUDP_Poll()はDelay_WithCANPoll()内でも呼んでいる
        // (数ms粒度の応答性確保)ので、ここでの呼び出しは無くても実用上問題ないが、
        // Delay_WithCANPoll()を挟まない一瞬の間も取りこぼさないよう念のため呼ぶ。
        HLControlUDP_Poll();

  }
  /* USER CODE END 3 */
}

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
/* USER CODE BEGIN 4 */
void ws2812_fill_buffer(void)
{
    int idx = 0;

    for (int i = 0; i < LED_NUM; i++) {
        uint8_t g = led_data[i][0];
        uint8_t r = led_data[i][1];
        uint8_t b = led_data[i][2];

        uint8_t grb[3] = {g, r, b};

        for (int c = 0; c < 3; c++) {
            for (int bit = 7; bit >= 0; bit--) {
                if (grb[c] & (1 << bit)) {
                    ws2812_buf[idx++] = T1H;
                } else {
                    ws2812_buf[idx++] = T0H;
                }
            }
        }
    }
}

void ws2812_show(void)
{
    // 前回の転送が終わるまで待つ
    while (ws2812_busy);

    ws2812_fill_buffer();

    ws2812_busy = 1;

    HAL_TIM_PWM_Start_DMA(&htim1, TIM_CHANNEL_1,
                          (uint32_t*)ws2812_buf,
                          WS2812_BITS);
}

void HAL_TIM_PWM_PulseFinishedCallback(TIM_HandleTypeDef *htim)
{
    if (htim->Instance == TIM1) {
        // PWM + DMA 停止
        HAL_TIM_PWM_Stop_DMA(&htim1, TIM_CHANNEL_1);

        // 出力を Low に固定（リセットパルス用）
        __HAL_TIM_SET_COMPARE(&htim1, TIM_CHANNEL_1, 0);

        // 50µs 以上 Low を維持（ここはブロッキングでもOK）
        // 48MHz / 1us = 48カウントなので、適当に待つなら：
        for (volatile int i = 0; i < 3000; i++); // 数十µs〜

        ws2812_busy = 0;
    }
}

/* USER CODE END 4 */
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
