SameSameIndustry/STM32_UDP2CAN_controller/(commit log)

2026-08-07 Initial commit: KiCad PCB + STM32G431 firmware (CubeIDE and CubeMX/CMake) for W5500 UDP controller
2026-08-28 Fix W5500 UDP startup reliability (SPI slew rate + power-on reset timing)
    電源投入直後にUDP通信が開始されない(たまに成功する)問題への対策2点:
    1. SPI1 SCK/MISO/MOSI (PA5/6/7) のGPIOスルーレートを
    GPIO_SPEED_FREQ_LOW -> VERY_HIGH に変更。24MHz動作なのに既定のLOW
    (~2MHz相当) では起動時のSPI通信が個体差・温度で不安定になっていた。
    HAL_SPI_MspInit の USER CODE ブロック内で上書き (CubeMX再生成でも保持)。
    2. W5500のリセットシーケンス見直し (main.c USER CODE 2):
    - リセット前に HAL_Delay(200) を追加し3.3Vレール安定を待つ
    - リセット解除後の待ちを 50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
2026-08-28 Add GIM6010-8 / GIM8018-8 motor libraries and 2-motor position control tool
    出力軸(減速後)の絶対角度による位置制御に特化したモータードライバを追加。
    ファーム (G431_w5500/, CMake版):
    - odrive_can.* を拡張 (既存API・main.cの使い方は不変):
    - フィードバック構造体に iq_setpoint/iq_measured/vbus_voltage/ibus_current
    - RXデコードに Get_Iq(0x014) / Get_Bus_Voltage(0x017)
    - 新規コマンド: EnableTorqueControl, Estop(0x002), ClearErrors(0x018),
    Reboot(0x016), SetLimits(0x00F), SetTrajVelLimit(0x011),
    SetTrajAccelLimits(0x012), SetPosGain(0x01A), SetVelGains(0x01B)
    - gim6010.c/.h (新規): GIM6010-8 ラッパー。o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
2026-08-29 twin motor control enable
2026-08-29 successfully update motor sending command
2026-09-05 Fix FDCAN TxFIFO overflow from unconditional GIM EnterPositionControl
    Round-robin re-assertion called EnterPositionControl() every loop
    regardless of current axis_state, unconditionally sending 2 CAN frames
    per axis. Combined with gim_axis's send and ResendLastTarget, this
    queued 4 frames per loop into the STM32G4's 3-slot FDCAN TxFIFO,
    dropping a frame every iteration (confirmed via heartbeat txQFail
    counter incrementing every ~1.5s). Now guards the call on axis_state
    so it only sends when the axis isn't already in closed-loop control.
    Also stop HLControlUDP_UpdateGim6010Sync() from sending Set_Input_Pos
    immediately every loop; it now only recomputes the trimmed target and
    lets the existin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
2026-09-05 Fix full main-loop hang from unbounded W5500 SPI HAL_MAX_DELAY
    W5500_ReadByte()/W5500_WriteByte() used HAL_SPI_Receive/Transmit with
    HAL_MAX_DELAY (no timeout). When SPI transfer failed to complete
    (observed live, repeatedly, right after commanding motors to move —
    consistent with motor-drive electrical noise/voltage transients
    disrupting the SPI lines), the call never returned, freezing the
    entire main loop forever: no heartbeat, no CAN bridge relay, no CAN
    commands sent at all. Recovering required a physical power cycle.
    Bound the transfer to a short timeout and, on failure, reset CS and
    reinit the SPI peripheral so the next call isn't permanently stuck.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
2026-09-05 Fix W5500 SPI recovery path still hanging via Error_Handler()
    W5500_SPI_Recover() (added to bound the previously-unlimited
    HAL_MAX_DELAY SPI transfers) called MX_SPI1_Init() to reinit the
    peripheral after a timeout, but MX_SPI1_Init() calls Error_Handler()
    (__disable_irq(); while(1){}) if HAL_SPI_Init() fails — reproducing
    the exact same permanent hang the timeout was meant to prevent,
    confirmed live when a larger motor move (100deg) triggered it again
    even with the timeout in place.
    Extracted the field setup + HAL_SPI_Init() call into SPI1_Configure(),
    used by both MX_SPI1_Init() (boot-time, still fatal via Error_Handler()
    on failure — appropriate then) and W5500_SPI_Recover() (runtime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
2026-09-05 Bound the while(getSn_CR(sn)) polling loops in the WIZnet ioLibrary
    socket.c had ~20 occurrences of `while (getSn_CR(sn));`, an unbounded
    poll waiting for the W5500's socket command register to clear. Each
    iteration reads through the already-timeout-bounded SPI byte
    transfers, but if the read value itself never reports "cleared" (e.g.
    during sustained motor-drive electrical noise), the outer loop itself
    never had any bound and froze the main loop forever — reproduced live
    during a 1-minute repeated-motion stress test, even after the SPI
    byte-transfer timeout fix.
    Replaced all occurrences with wait_Sn_CR_clear(sn), a capped retry
    (50 iterations) that gives up instead of looping forever. No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
2026-09-05 Retry FDCAN TxFIFO enqueue on transient full instead of dropping immediately
    hl_control_udp.c sends GIM8018 C(0x04) then D(0x05) back-to-back on
    every new pitch command. With only a 3-slot hardware TxFIFO, D (sent
    second) was statistically more likely to be dropped whenever the FIFO
    had less headroom at that instant, delaying D's response to a new
    target until the next round-robin resend (up to ~6s later) — observed
    live as D visibly lagging behind C.
    CANBus_Send() now waits briefly (up to 3ms, 1ms steps) for a free
    FIFO slot via HAL_FDCAN_GetTxFifoFreeLevel() before enqueueing, since
    a queued frame normally drains in a few hundred microseconds at bus
    speed. Falls through to the existing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
2026-09-05 Bound the remaining unlimited polling loops across the W5500 driver
    Following up on the getSn_CR fix, found several more genuinely
    unbounded loops in the same driver stack that a single SPI/chip
    glitch (motor-drive noise) can turn into a permanent main-loop hang:
    - socket.c sendto_IO_6(): while(1) waiting for Sn_IR_SENDOK or
    Sn_IR_TIMEOUT after every send — no non-blocking escape existed
    here at all (unlike the TX-free-size wait right above it), so any
    send whose completion flag never arrives hangs forever. This is on
    the hot path of every single UDP send in the project (heartbeat,
    CAN-UDP bridge relay, hl_control resend) and is the most likely
    culprit behind the hangs seen af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
2026-09-05 add i2c functions
2026-09-05 shrink odrive broadcast for better communiation
2026-09-07 c610 postion ccontorl with PID cascade
2026-09-11 ros 2 adapter for yaw and endeffecotr
2026-09-11 update PID gain for C610
2026-10-04 Prepare repo for public release: scrub personal paths, add README/LICENSE
    - Remove stale CubeIDE/G431_w5500 STM32CubeIDE project: superseded by the
    CMake-based G431_w5500 project since the initial commit, out of date
    (missing as5600/gim6010/hl_control_udp etc.), and its .launch files
    embedded an absolute user-profile path.
    - Remove the duplicated Autodesk Inventor 3D export tree under
    UDP_w5500/3D/3D/ and UDP_w5500/3D/UDP_w5500/UDP_w5500/: unused by the
    KiCad PCB (which references library models via KICAD9_3DMODEL_DIR), not
    needed for reproduction (UDP_w5500/3D/UDP_w5500.step is kept), and its
    .iam file embedded a user-profile temp path.
    - Stop tracking accidentally-committed _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
