SameSameIndustry/STM32_UDP2CAN_controller/(notices)

Notices in the files:
G431_w5500/Core/Src/main.c:
Copyright (c) 2026 STMicroelectronics.
All rights reserved.
This software is licensed under terms that can be found in the LICENSE file
